PyForce/rosie-motordriver/hardware/schematics.png

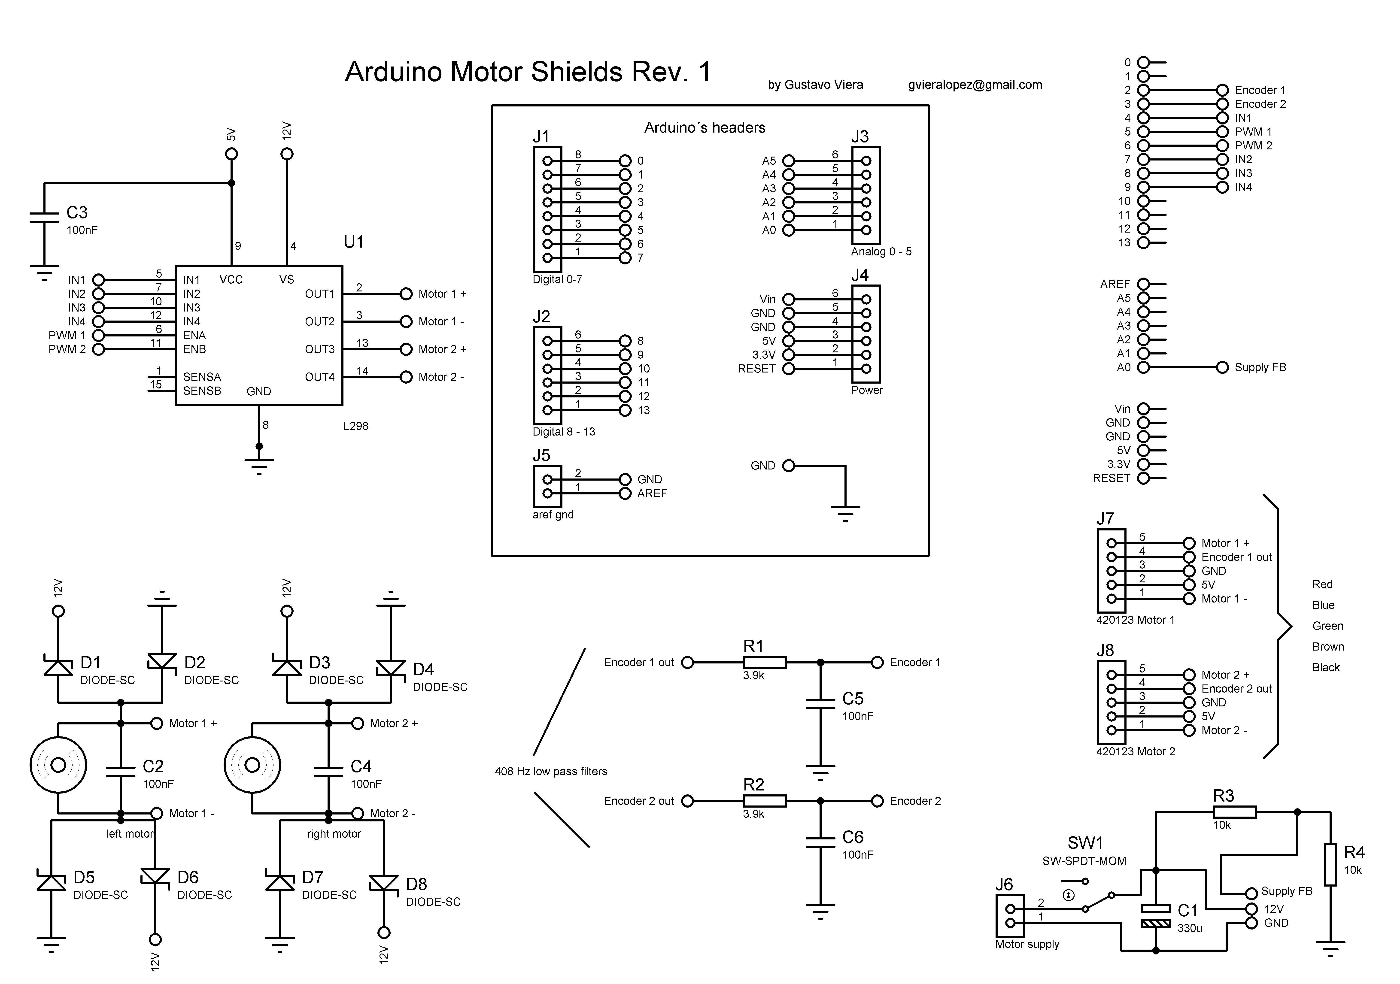
hardware/schematics.png
