PyForce/rosie-motordriver/hardware/top.pdf

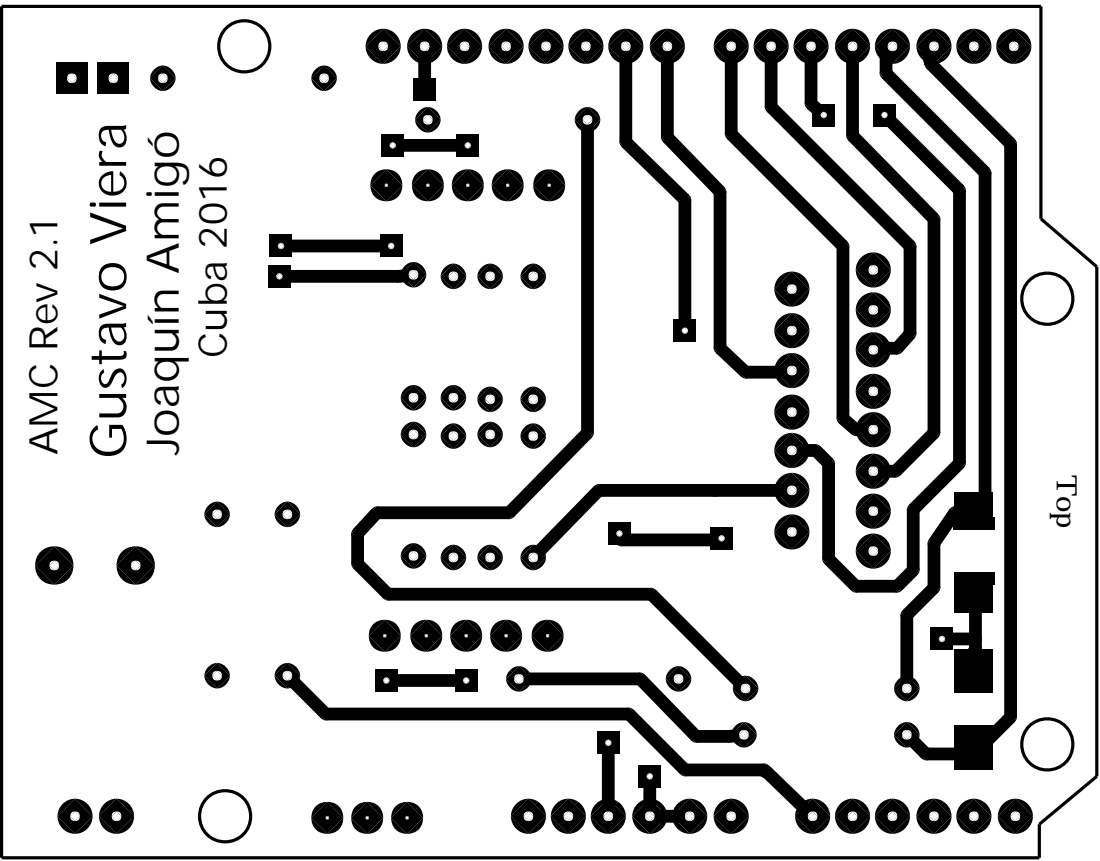
[picture p3: page 1]
Gustavo Viera; Top; Joaquín Amigó; Cuba 2016; AMC Rev 2.1
