PyForce/rosie-motordriver/hardware/bottom.pdf

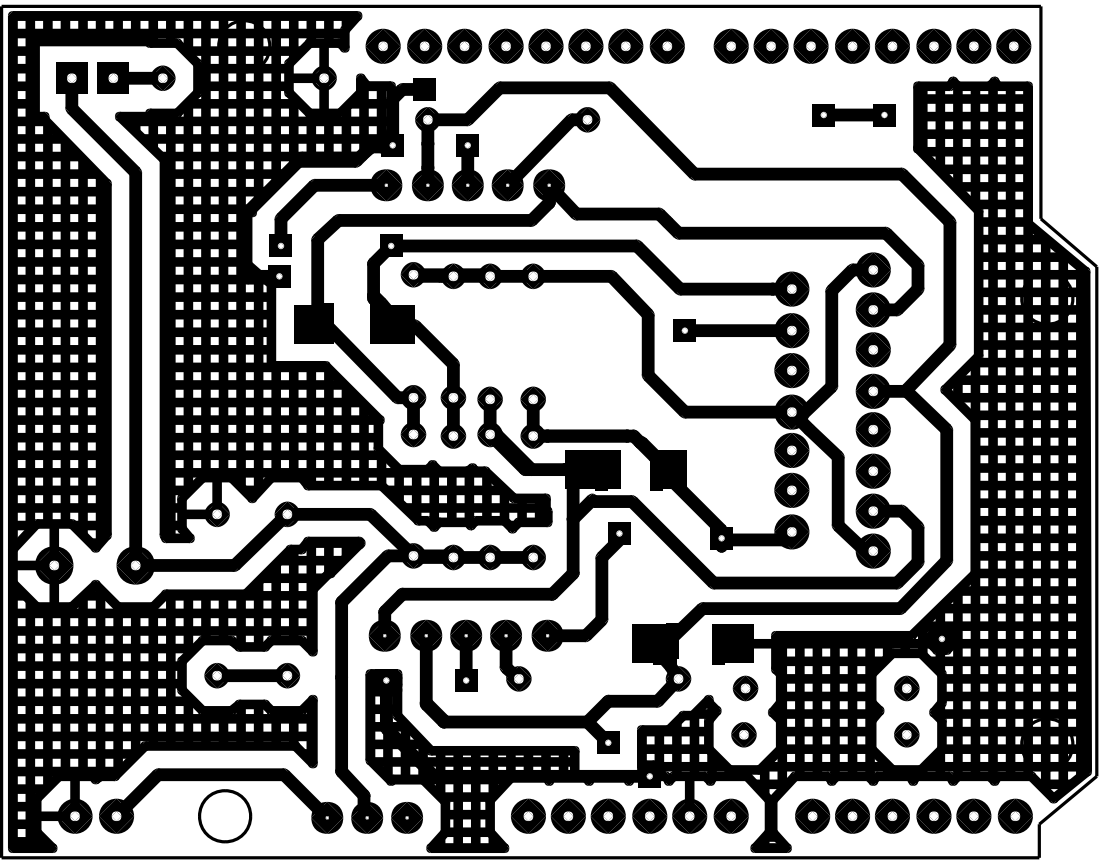
[picture p4: page 1]
