PyForce/rosie-motordriver/hardware/silk.pdf

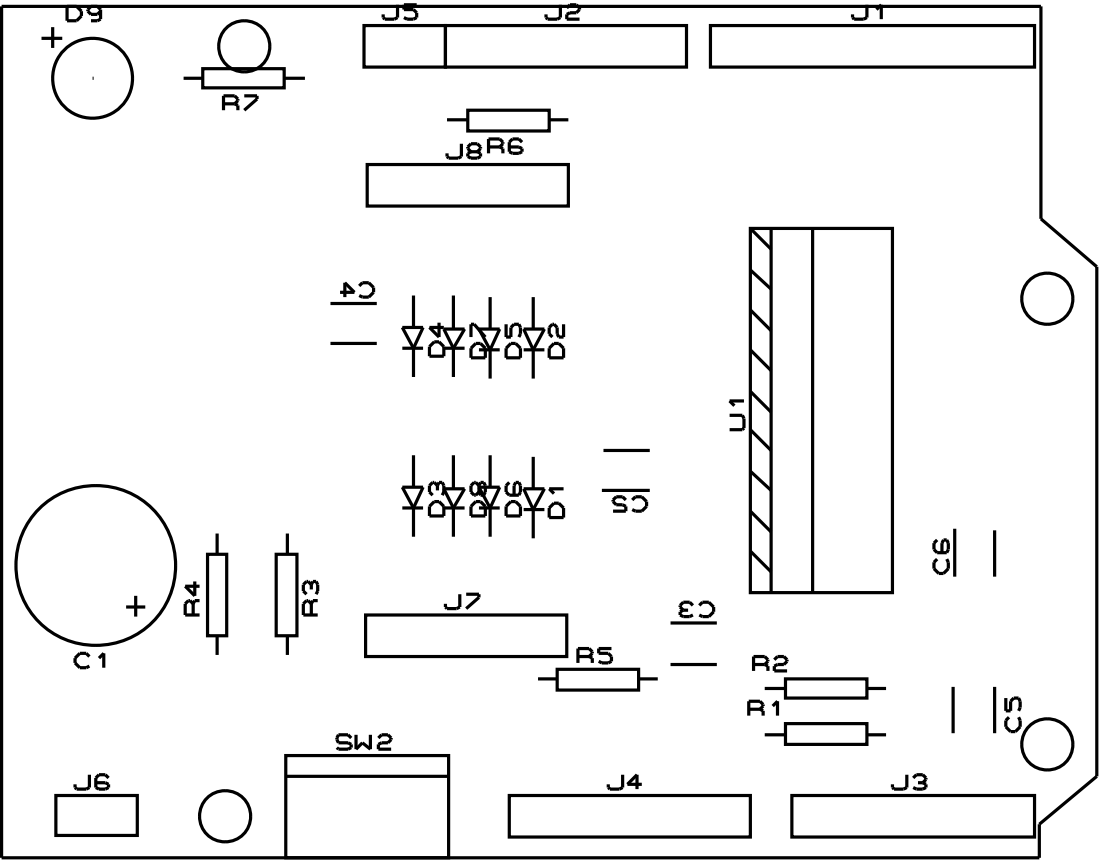
[picture p5: page 1]
