PyForce/rosie-motordriver/(commit log)

2017-05-21 Add Arduino script
2017-05-22 Add PCB layouts
2017-05-22 Add a 3D preview image of the board
2017-05-22 Add hardware schematics
2026-11-01 Move the board files into hardware/ and the sketch into firmware/, schematics as PNG
2026-11-01 Read the wheel speeds again in the setpoint command
